kameker/Gruzdy/PROJECT_STATUS.md

# Текущее состояние проекта

Обновление: после исходного снимка добавлены выдача импульсов аппаратным таймером и защита от запоздавших и повторных команд. При потере ответа на запуск интерфейс пытается остановить двигатель и блокирует запуск до подтверждения. HTTP-сервер по-прежнему обрабатывает запросы последовательно, поэтому обработка остановки может задержаться; на оборудовании это не проверено. Актуальное состояние Git проверяйте отдельно.

Снимок на 9 ноября 2026 года. Документ описывает рабочую копию, включая ещё не закоммиченные изменения.

## Назначение и работа

Проект содержит прошивку для ESP32 Dev Module (`esp32dev`) с Arduino и PlatformIO. Она управляет шаговым двигателем M49SP-2K через драйвер DRV8825 и веб-страницу в собственной точке доступа ESP32. Пользователь задаёт целое число оборотов от 1 до 1000 и направление; при выполнении повторный запуск отклоняется. Доступна остановка по Wi-Fi.

- Для расчёта используется 48 полных шагов на оборот. STEP подключается к GPIO25, DIR — к GPIO26; интервал шагов в коде составляет 10 000 мкс.
- Точка доступа и HTTP Basic-аутентификация настроены в `src/main.cpp`; адрес страницы по умолчанию — `http://192.168.4.1/`. Пароли по умолчанию следует заменить перед использованием. HTTP не шифрует соединение.
- Программная кнопка остановки прекращает импульсы, но зависит от связи и контроллера и не отключает питание двигателя. Для защиты нужна независимая аппаратная остановка. Программа не контролирует фактическое положение и пропуск шагов.
- Схема подключения, настройки драйвера и инструкции по использованию приведены в `README.md`.

## Основные файлы

- `src/main.cpp` — точка доступа, веб-сервер, обработчики команд и выдача импульсов.
- `src/index.html` — интерфейс и клиентская логика; файл включается в прошивку через `board_build.embed_txtfiles` в `platformio.ini`.
- `include/move_command.h` — проверка ввода и состояние движения.
- `test/test_move.cpp` — тесты проверки ввода, движения и остановки.
- `platformio.ini` — конфигурация сборки `esp32dev`.

## Состояние Git

На момент создания снимка ветка `main` указывает на коммит `a961d5d` (`Add motor stop control`), совпадающий с `origin/main` по последней локально известной ссылке. До создания этого документа имелись незакоммиченные изменения в `README.md`, `platformio.ini`, `src/main.cpp` и новый неотслеживаемый `src/index.html`: страница вынесена из C++ в отдельный файл и подключена к сборке. Эти изменения остаются в рабочей копии; коммит не создавался. Сам этот документ также является новым файлом.

## Проверка на дату снимка

- `pio run` выполнена успешно с локальной установкой PlatformIO; сборка для `esp32dev`, платформа Espressif 32 версии 8.0.0. Получена прошивка `.pio/build/esp32dev/firmware.bin`.
- `test/test_move.cpp` скомпилирован локальным `g++` и выполнен успешно.
- Загрузка на ESP32, работа веб-интерфейса, Wi-Fi, драйвера и двигателя на реальном оборудовании в рамках этой проверки не выполнялись.

Для продолжения: проверить прошивку и подключение на оборудовании, включая направление, остановку и параметры конкретного двигателя; при необходимости затем сохранить изменения в Git.
