kameker/Gruzdy/models/m3d/Сборка.stp

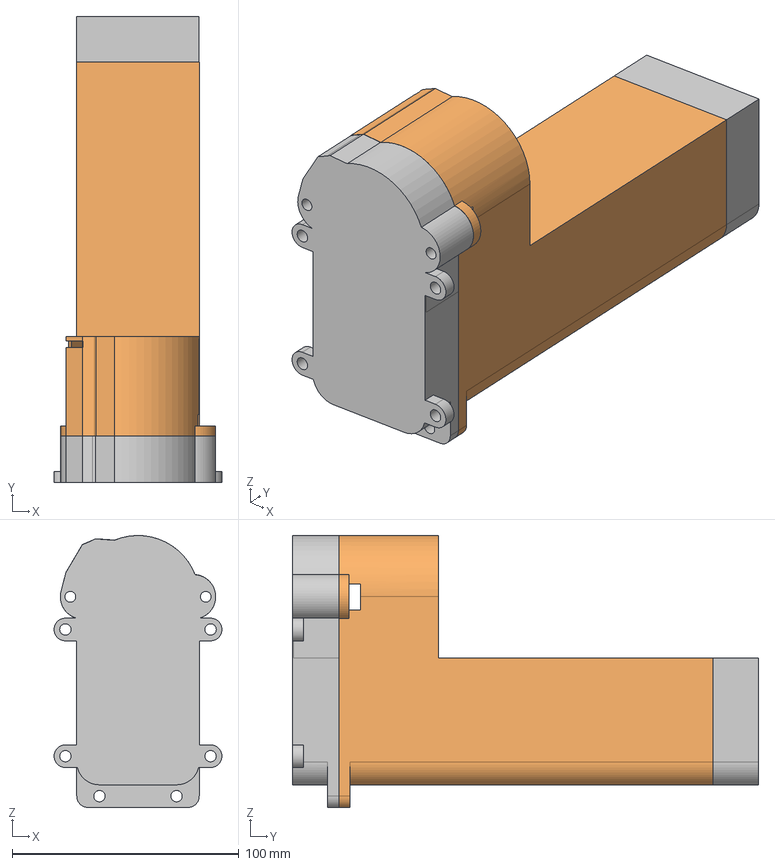
[picture p1: CAD file, 2026-11-11]
models/m3d/Сборка.stp
74.0 x 205.5 x 119.9 mm
UPLOCK
CENTER
GEAR48L
GEAR48R
pinion_12T
