kameker/Gruzdy/models/test/верхняя крышка.stp

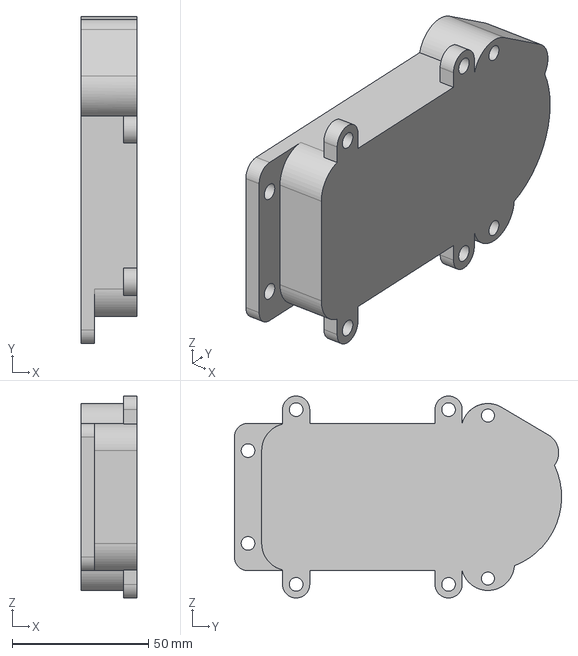
[picture p2: CAD file, 2026-11-11]
models/test/верхняя крышка.stp
20.5 x 119.9 x 74.0 mm
