kameker/Gruzdy/models/step/центральная часть.stp

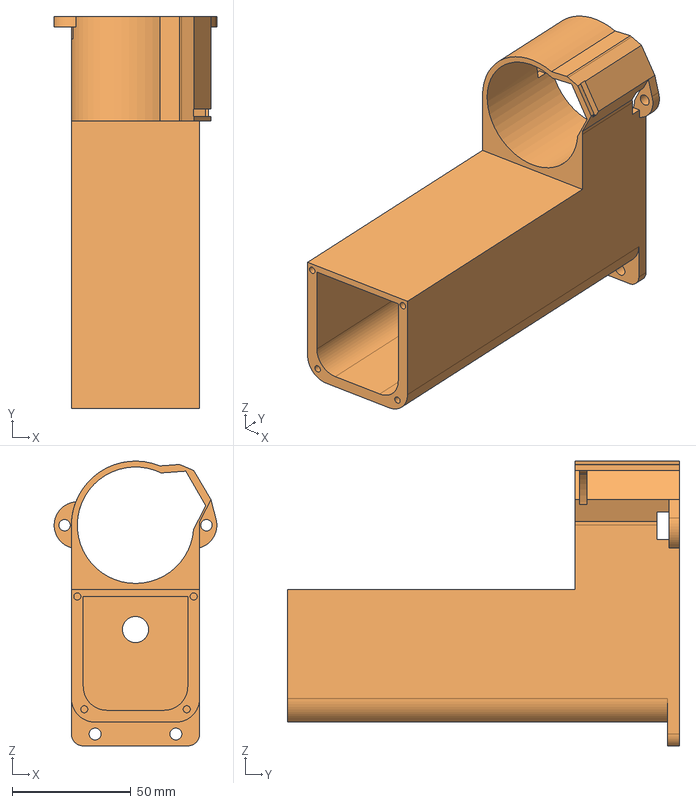
[picture p3: CAD file, 2026-11-13]
models/step/центральная часть.stp
68.5 x 165.0 x 119.9 mm
