kameker/Gruzdy/models/test/test2.stp

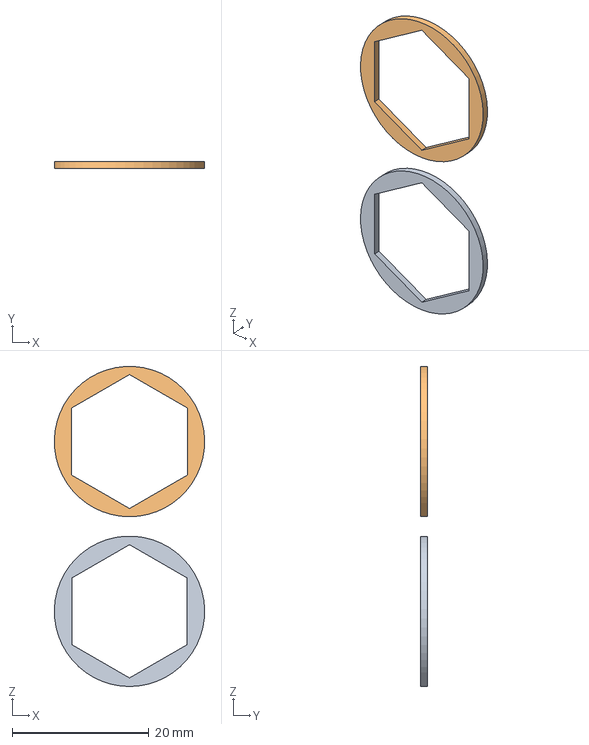
[picture p4: CAD file, 2026-11-10]
models/test/test2.stp
22.0 x 1.00 x 46.8 mm
