kameker/Gruzdy/models/step/gear48R.stp

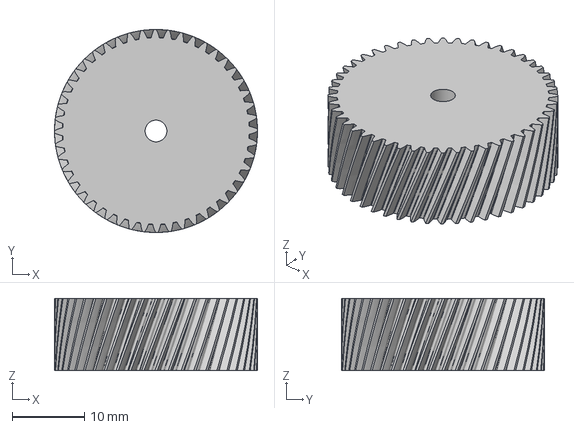
[picture p5: CAD file, 2026-11-11]
models/step/gear48R.stp
28.0 x 28.0 x 10.0 mm
