kameker/Gruzdy/models/test/test.stp

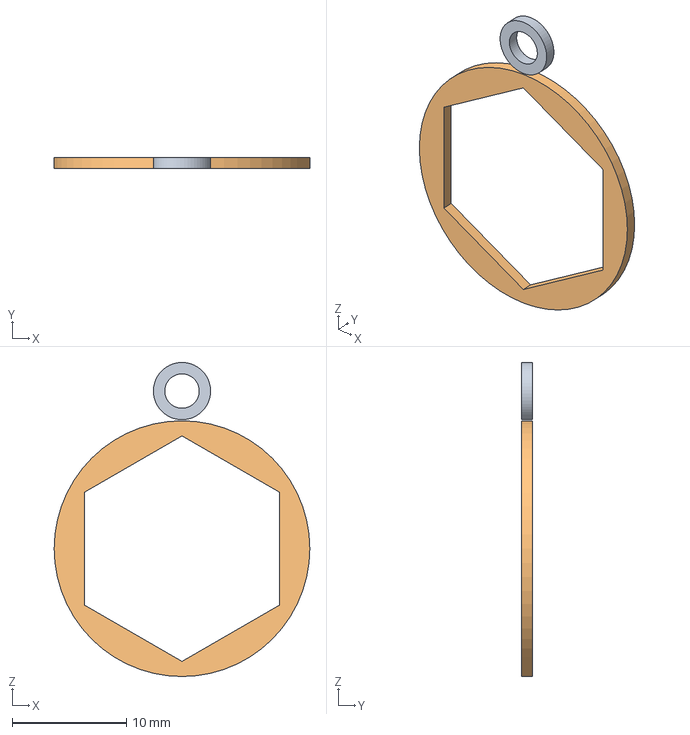
[picture p6: CAD file, 2026-11-10]
models/test/test.stp
22.3 x 1.00 x 27.4 mm
