kameker/Gruzdy/models/step/gear48L.stp

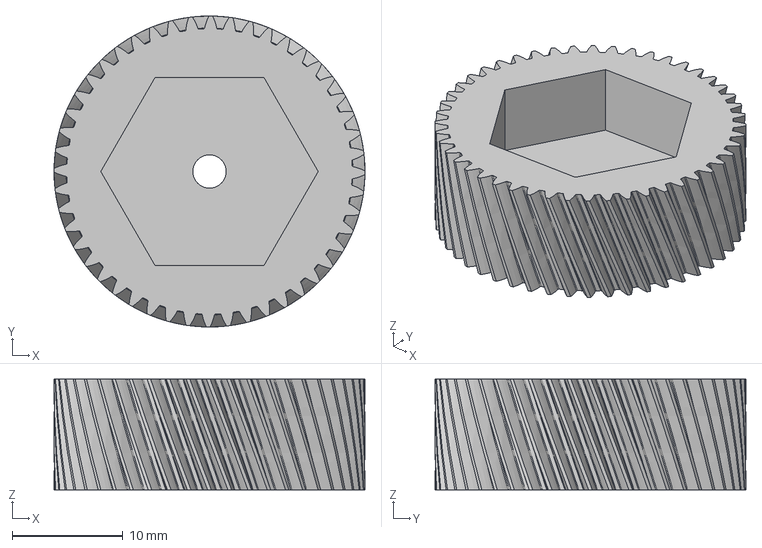
[picture p7: CAD file, 2026-11-11]
models/step/gear48L.stp
28.0 x 28.0 x 10.0 mm
