kameker/Gruzdy/models/step/вагон.stp

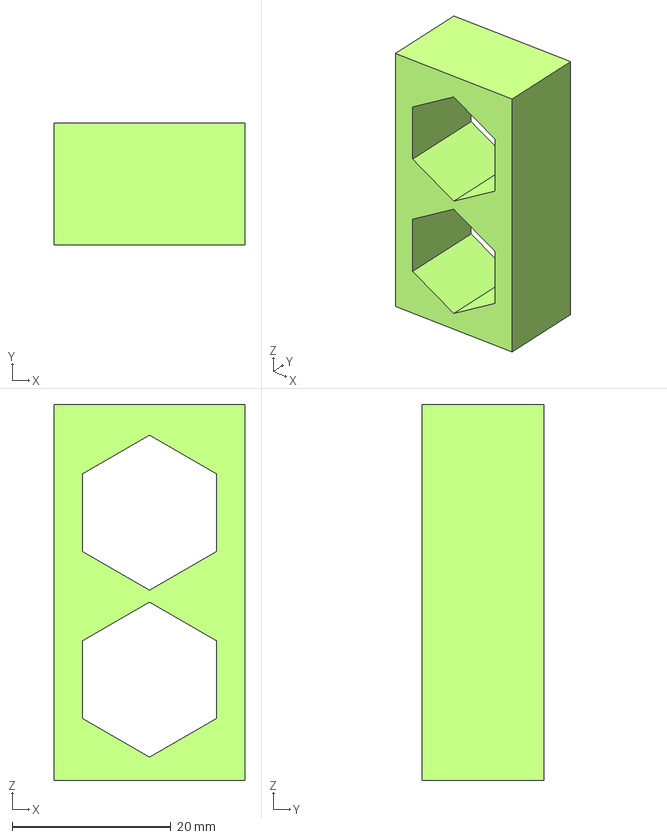
[picture p8: CAD file, 2026-11-11]
models/step/вагон.stp
24.0 x 15.4 x 47.3 mm
