kameker/Gruzdy/models/step/нижняя крышка.stp

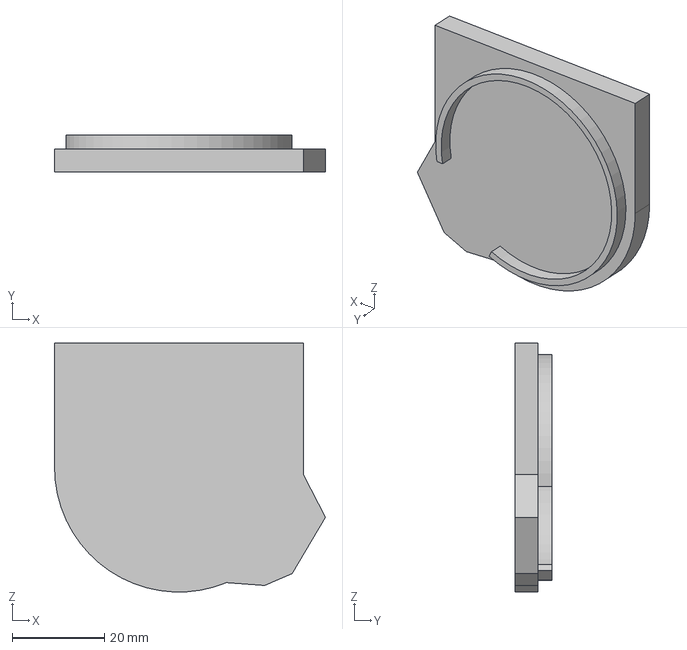
[picture p9: CAD file, 2026-11-11]
models/step/нижняя крышка.stp
58.8 x 8.00 x 54.0 mm
