kameker/Gruzdy/models/step/gear12.stp

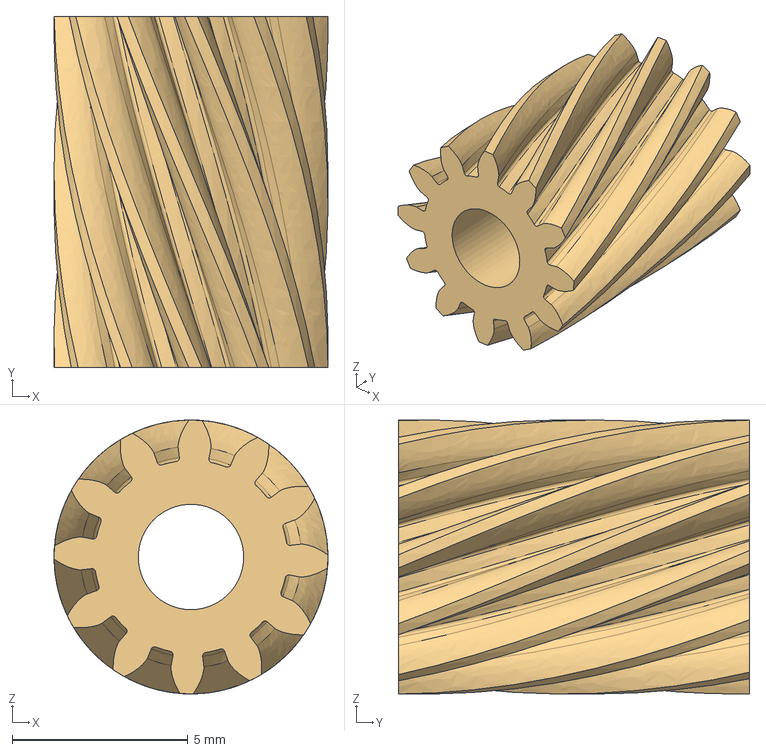
[picture p10: CAD file, 2026-11-11]
models/step/gear12.stp
7.80 x 10.0 x 7.80 mm
