kameker/Gruzdy/(list of files, cad)

Other CAD files:
models/step/верх2.stp
models/step/верхняя крышка.stp
