kameker/Gruzdy/test/test_move.cpp

#include <cassert>
#include "move_command.h"

int main() {
  uint32_t steps = 0;
  assert(parseRevolutions("1", steps) && steps == 48);
  assert(parseRevolutions("5", steps) && steps == 240);
  assert(parseRevolutions("1000", steps) && steps == 48000);
  assert(!parseRevolutions("0", steps));
  assert(!parseRevolutions("1001", steps));
  assert(!parseRevolutions("-1", steps));
  assert(!parseRevolutions("1.5", steps));
  assert(!parseRevolutions("5abc", steps));
  assert(!parseRevolutions("", steps));

  MotorMove motor;
  assert(motor.start(240));
  motor.step();
  assert(motor.busy());
  motor.stop();
  assert(!motor.busy());
  motor.step();
  assert(!motor.busy());
  assert(motor.start(48));
  for (int i = 0; i < 48; ++i) motor.step();
  assert(!motor.busy());
}
