kameker/Gruzdy/(commit log)

2026-11-09 Add Wi-Fi motor control
2026-11-09 Add motor stop control
2026-11-09 Improve motor control and document project
2026-11-10 added 3d models of actuator
    [gear12.stp, gear48L.stp, gear48R.stp, test.stp, вагон.stp, верх2.stp, верхняя крышка.stp, нижняя крышка.stp]
2026-11-11 обновил модели
    [gear12.stp, gear48L.stp, gear48R.stp, Сборка.stp, вагон.stp, верх2.stp, верхняя крышка.stp, нижняя крышка.stp]
2026-11-11 валы
    [вал1715.stp, вал17152.stp]
2026-11-13 финал
    [верх2.stp, центральная часть.stp]
